MJHimselff/xth-sense-wireless/docs/bracelet-diagram.pdf

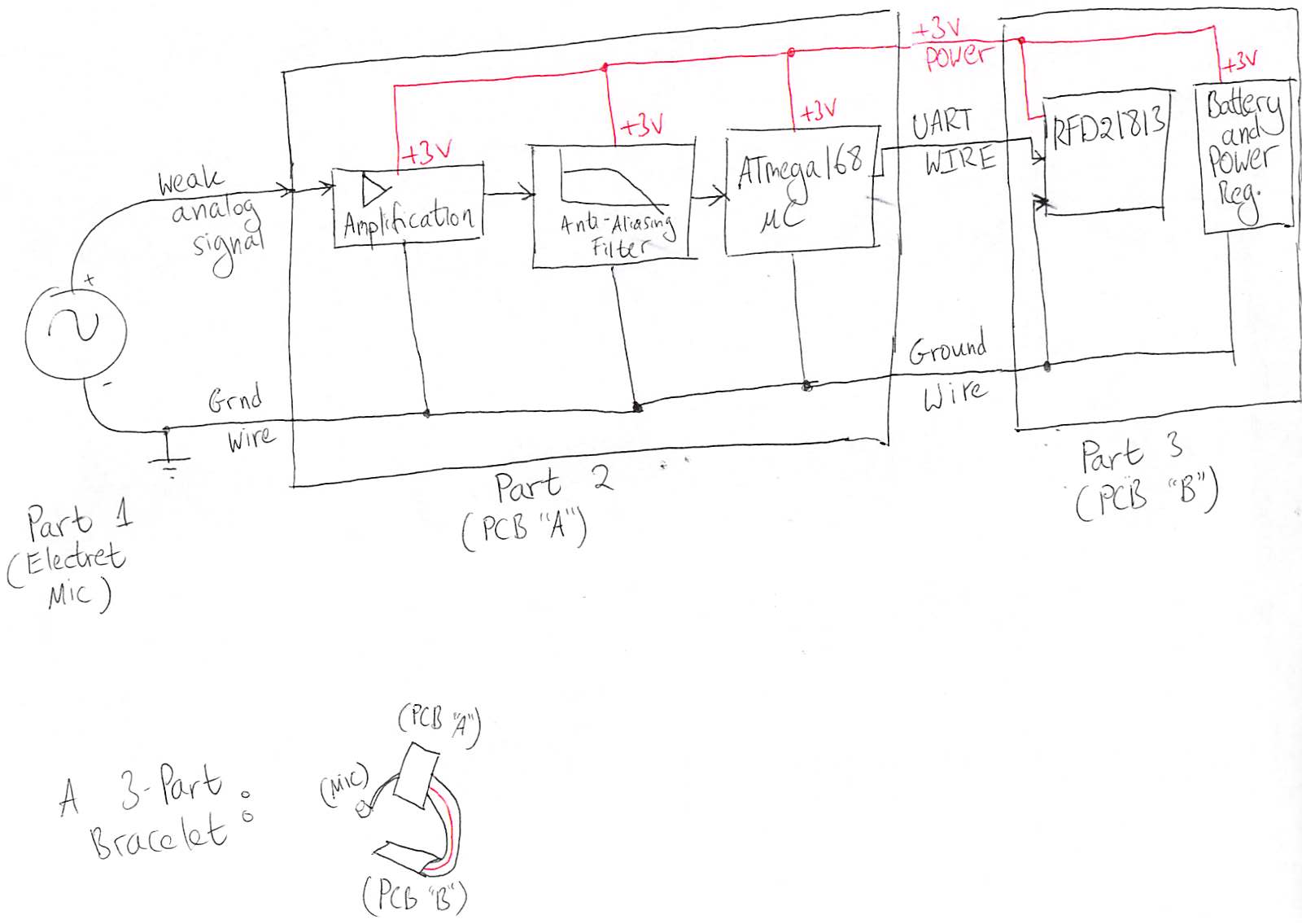
[picture p1: page 1]
