MJHimselff/xth-sense-wireless/docs/design-images/board.png

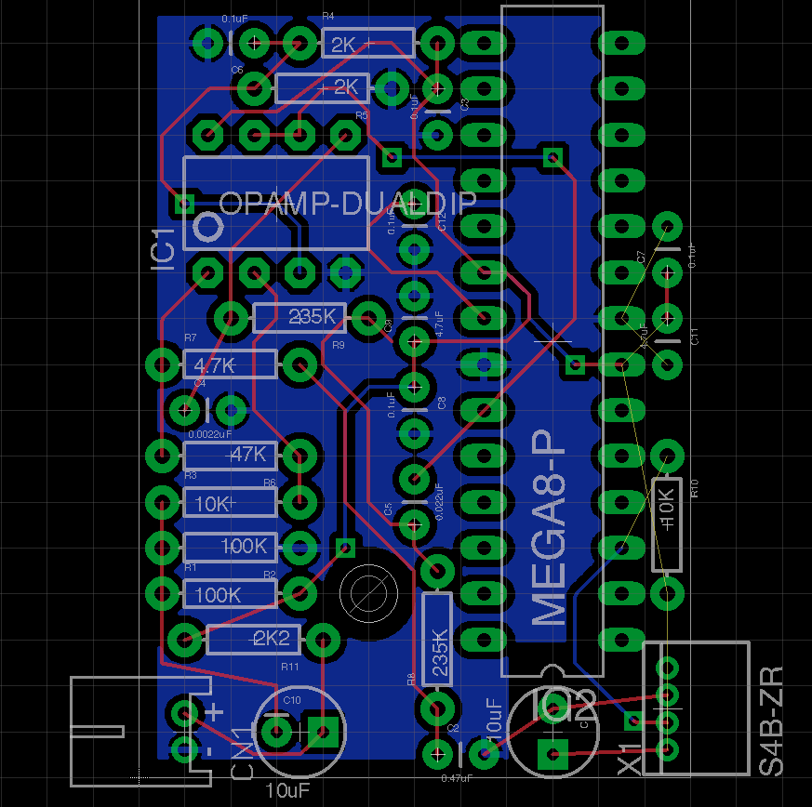
docs/design-images/board.png
