MJHimselff/xth-sense-wireless/docs/design-images/schem.png

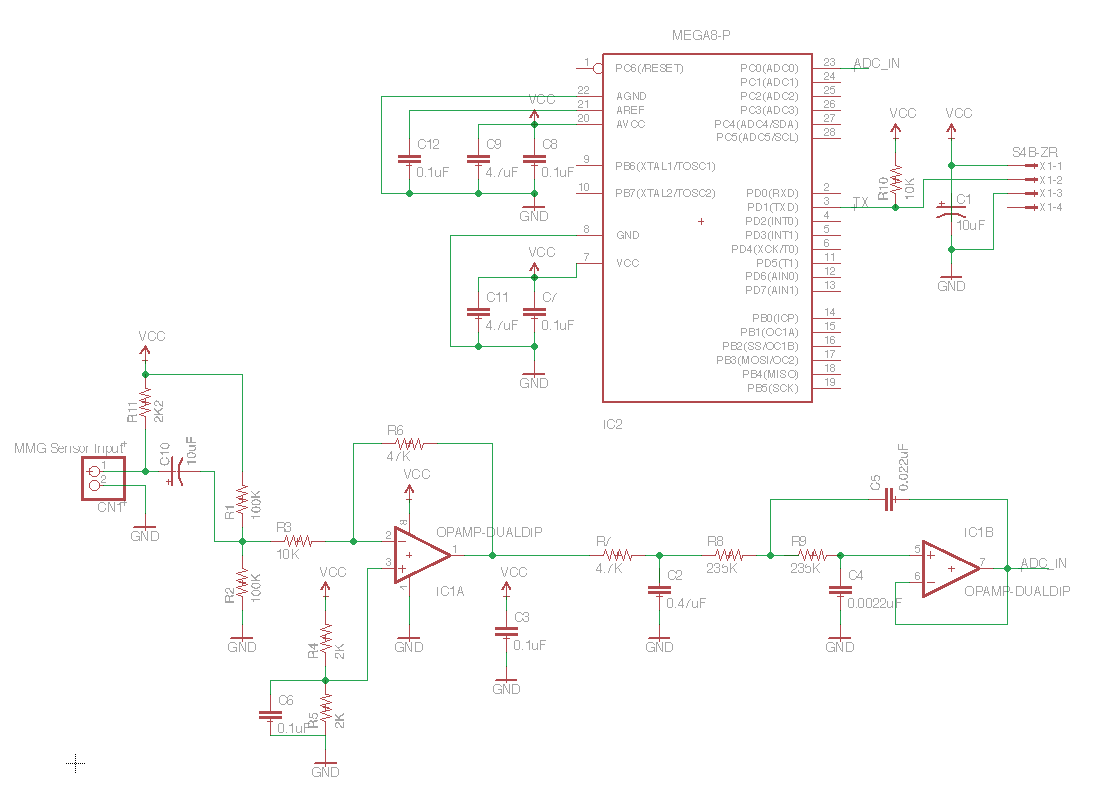
docs/design-images/schem.png
