MJHimselff/xth-sense-wireless/docs/pcb-diagrams.png

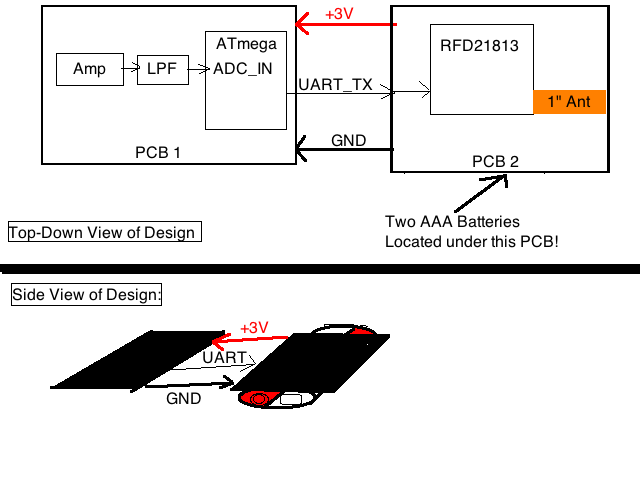
docs/pcb-diagrams.png
