MJHimselff/xth-sense-wireless/docs/xth-sense-anti-aliasing-schem.png

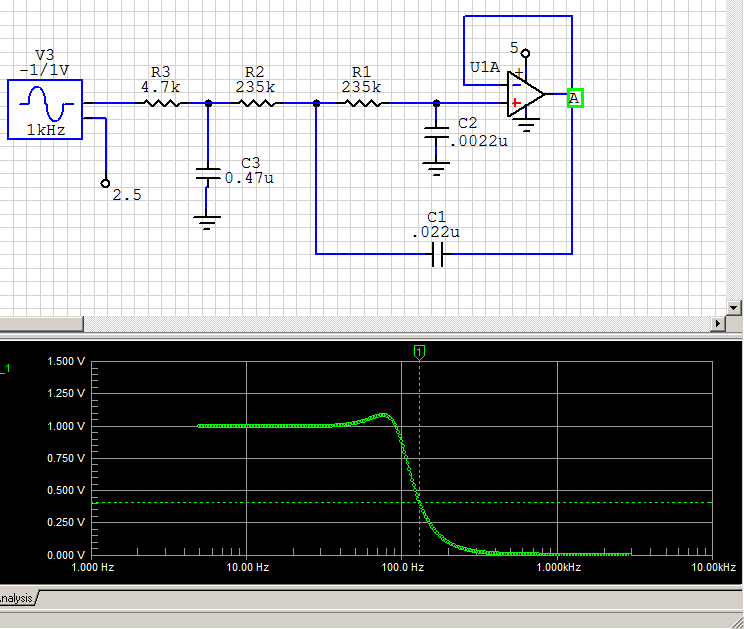
docs/xth-sense-anti-aliasing-schem.png
