MJHimselff/xth-sense-wireless/pcb/xth-sense-wireless.brd

## EAGLE design pcb/xth-sense-wireless.brd (2013-02-28)

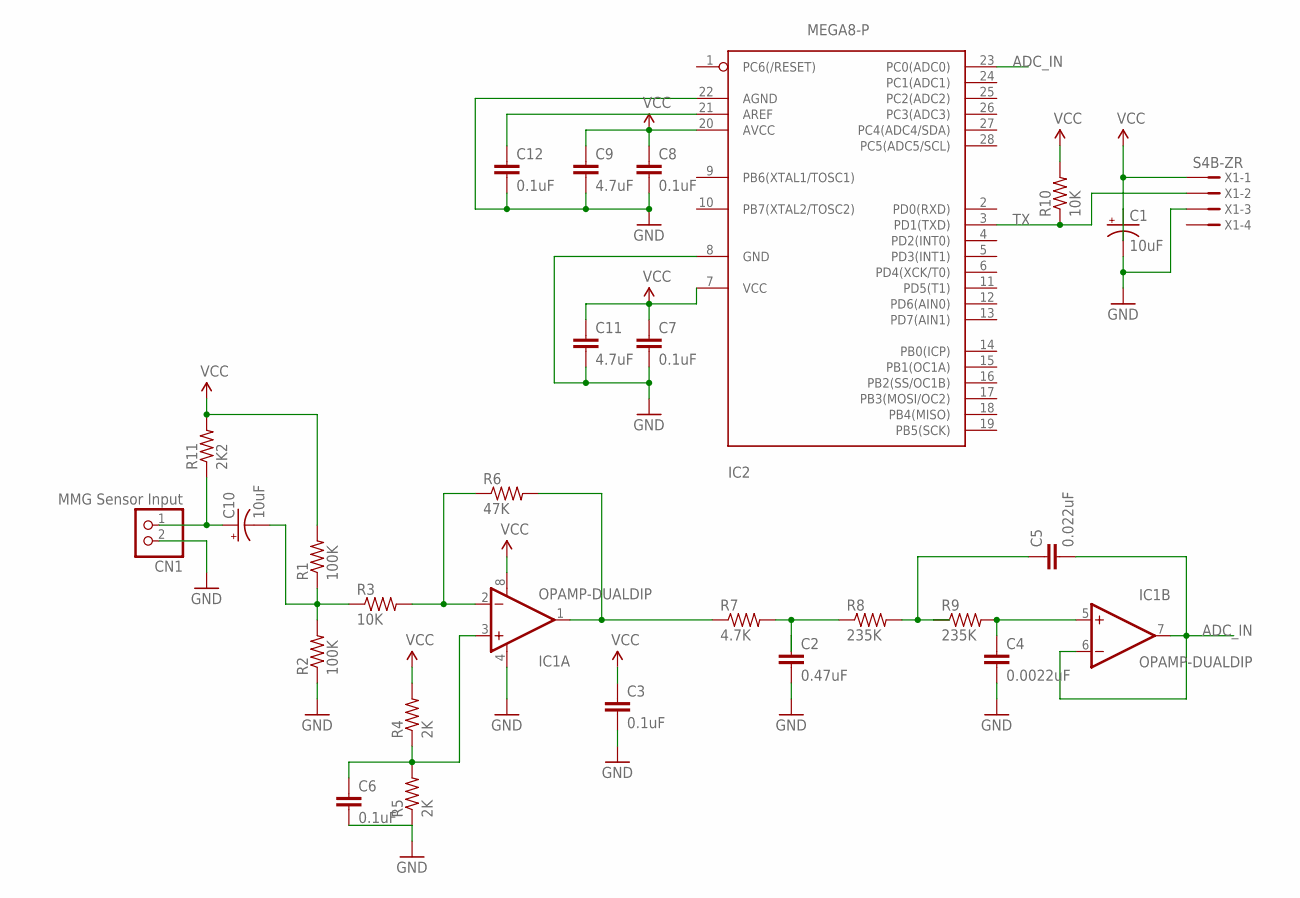
[picture p7: schematic xth-sense-wireless.sch]

Parts:
C1, C10: 10uF; CPOL-RADIAL-10UF-25V
C2: 0.47uF; CAP-PTH-SMALL
C3, C6, C7, C8, C12: 0.1uF; CAP-PTH-SMALL
C4: 0.0022uF; CAP-PTH-SMALL
C5: 0.022uF; CAP-PTH-SMALL
C9, C11: 4.7uF; CAP-PTH-SMALL
CN1: MMG Sensor Input; JST-PH-2-THM-RA
IC1: OPAMP-DUALDIP; DIP08
IC2: MEGA8-P; DIL28-3
R1, R2: 100K; AXIAL-0.3
R3, R10: 10K; AXIAL-0.3
R4, R5: 2K; AXIAL-0.3
R6: 47K; AXIAL-0.3
R7: 4.7K; AXIAL-0.3
R8, R9: 235K; AXIAL-0.3
R11: 2K2; AXIAL-0.3
X1: S4B-ZR

Connections:
ADC_IN: C5.2, IC1.6 (-IN), IC1.7 (OUT), IC2.23 (PC0(ADC0))
GND: C1.2 (-), C2.2, C3.2, C4.2, C6.2, C7.2, C8.2, C9.2, C11.2, C12.2, CN1.2 (1), IC1.4 (V-), IC2.8 (GND), IC2.22 (AGND), R2.P$1 (1), R5.P$1 (1), X1.3
unnamed: C10.2 (-), R1.P$1 (1), R2.P$2 (2), R3.P$1 (1)
unnamed: IC1.1 (OUT), R6.P$2 (2), R7.P$1 (1)
unnamed: IC1.2 (-IN), R3.P$2 (2), R6.P$1 (1)
unnamed: C2.1, R7.P$2 (2), R8.P$1 (1)
unnamed: C10.1 (+), CN1.1 (2), R11.P$1 (1)
unnamed: C4.1, IC1.5 (+IN), R9.P$2 (2)
unnamed: C5.1, R8.P$2 (2), R9.P$1 (1)
unnamed: C12.1, IC2.21 (AREF)
TX: IC2.3 (PD1(TXD)), R10.P$1 (1), X1.2
VCC: C1.1 (+), C3.1, C7.1, C8.1, C9.1, C11.1, IC1.8 (V+), IC2.7 (VCC), IC2.20 (AVCC), R1.P$2 (2), R4.P$2 (2), R10.P$2 (2), R11.P$2 (2), X1.1
VIRT_GND: C6.1, IC1.3 (+IN), R4.P$1 (1), R5.P$2 (2)

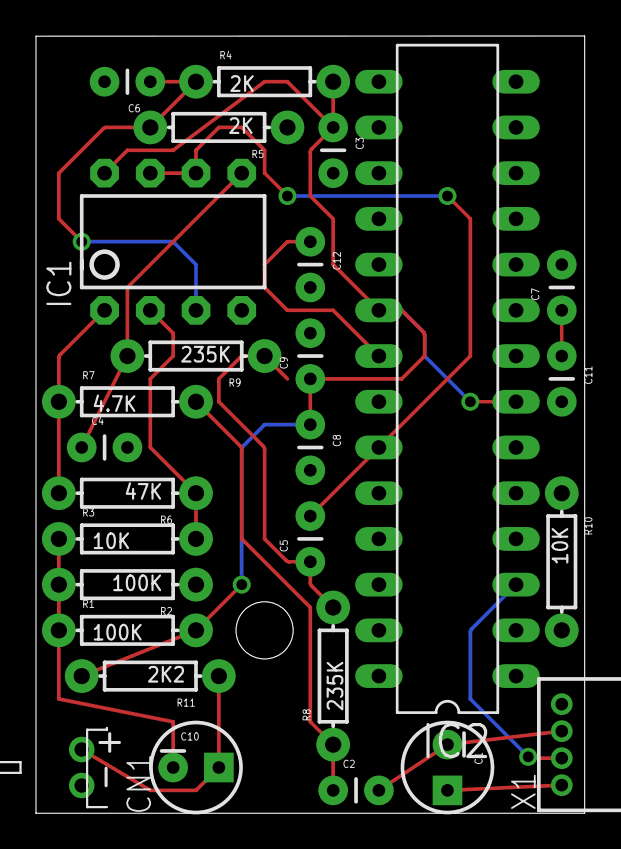
[picture p8: board xth-sense-wireless.brd from above]

Board: 2 copper layers, 30.5 x 43.2 mm, 27 parts (0 on the bottom side), 13 nets.
