MJHimselff/xth-sense-wireless/(commit log)

2013-02-24 started board layout
    [xth-sense-wireless.sch]
2013-02-24 added image of schematic for anti-aliasing filter
2013-02-26 updadted schematic.
    [xth-sense-wireless.sch]
2013-02-28 fnished schematic nad board layout (except for ground plane in lower-right corner. put one in for the digital grounds…)
    [xth-sense-wireless.brd, xth-sense-wireless.sch]
